nekowokaburu/GeneRev3/README.md

# GeneRev3 - Roaster automation with LCD display

See the [Gene Mod Manual.pdf](https://github.com/nekowokaburu/GeneRev3/blob/master/GeneModManual.pdf) for a description or [Gene CVB 101 Automation](https://github.com/nekowokaburu/GeneCBR101Automation) for the updated project implementing wifi.
