nekowokaburu/GeneRev3/LCDML_Gene_Rev_2____0036_bugfix01/LCDML_DISP.ino

// =====================================================================
//
// Output function
//
// =====================================================================

/* ******************************************************************** */
void LCDML_lcd_menu_display()
/* ******************************************************************** */
{
  // for first test set font here
  u8g.setFont(_LCDML_u8g_font);
  u8g.setColorIndex(1); // Instructs the display to draw with a pixel on.

  if (LCDML_DISP_update()) {

    // init vars
    uint8_t n_max = (LCDML.getChilds() >= _LCDML_u8g_rows) ? ((_LCDML_u8g_rows > _LCDML_u8g_rows_max) ? _LCDML_u8g_rows : _LCDML_u8g_rows_max) : (LCDML.getChilds());

    // set page
    u8g.firstPage();

    // generate content
    do {

      // display rows and cursor
      for (uint8_t n = 0; n < n_max; n++)
      {
        // set cursor
        if (n == LCDML.getCursorPos()) {
          u8g.drawStr( 0, _LCDML_u8g_font_h * (n + 1),  "X");
        }

        // set content
        u8g.drawStr( 10, _LCDML_u8g_font_h * (n + 1), LCDML.content[n]);
      }

      // display scrollbar when more content as rows available
      if (LCDML.getChilds() > n_max) {

        // set frame for scrollbar
        u8g.drawFrame(_LCDML_u8g_lcd_w - _LCDML_u8g_scrollbar_w, 0, _LCDML_u8g_scrollbar_w, _LCDML_u8g_lcd_h);

        // calculate scrollbar length
        uint8_t scrollbar_block_length = LCDML.getChilds() - n_max;
        scrollbar_block_length = _LCDML_u8g_lcd_h / (scrollbar_block_length + _LCDML_DISP_rows);

        //set scrollbar
        if (LCDML.getCursorPosAbs() == 0) {                                   // top position     (min)
          u8g.drawBox(_LCDML_u8g_lcd_w - (_LCDML_u8g_scrollbar_w - 1), 1                                                    , (_LCDML_u8g_scrollbar_w - 2)  , scrollbar_block_length);
        }
        else if (LCDML.getCursorPosAbs() == (LCDML.getChilds())) {            // bottom position  (max)
          u8g.drawBox(_LCDML_u8g_lcd_w - (_LCDML_u8g_scrollbar_w - 1), _LCDML_u8g_lcd_h - scrollbar_block_length            , (_LCDML_u8g_scrollbar_w - 2)  , scrollbar_block_length);
        }
        else {                                                                // between top and bottom
          u8g.drawBox(_LCDML_u8g_lcd_w - (_LCDML_u8g_scrollbar_w - 1), (scrollbar_block_length * LCDML.getCursorPosAbs() + 1), (_LCDML_u8g_scrollbar_w - 2)  , scrollbar_block_length);
        }
      }
    } while ( u8g.nextPage() );
  }

  // reinit some vars
  LCDML_DISP_update_end();
}

// lcd clear
void LCDML_lcd_menu_clear()
{
}
